Chloxeo/SCALAR-7_Sequenceur/images/BOTTOM.png

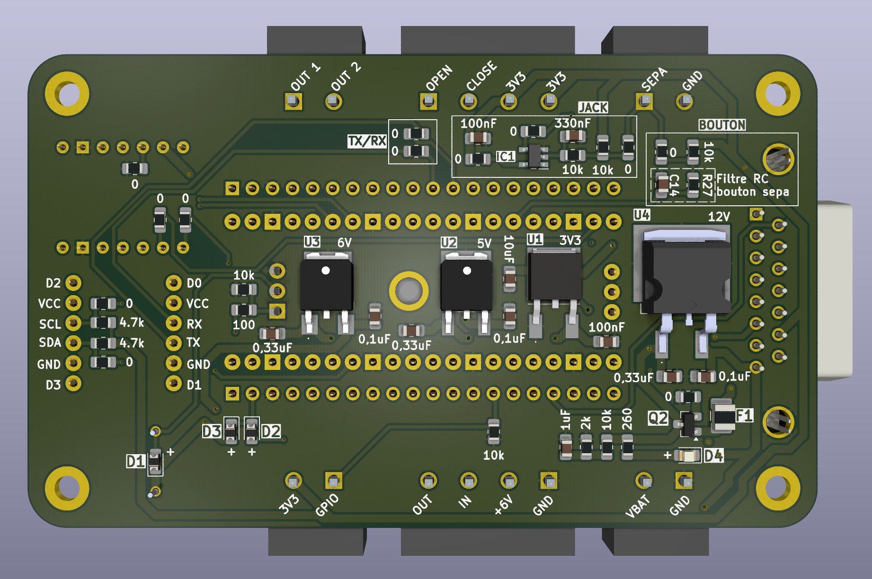
images/BOTTOM.png
