Chloxeo/SCALAR-7_Sequenceur/images/FRONT.png

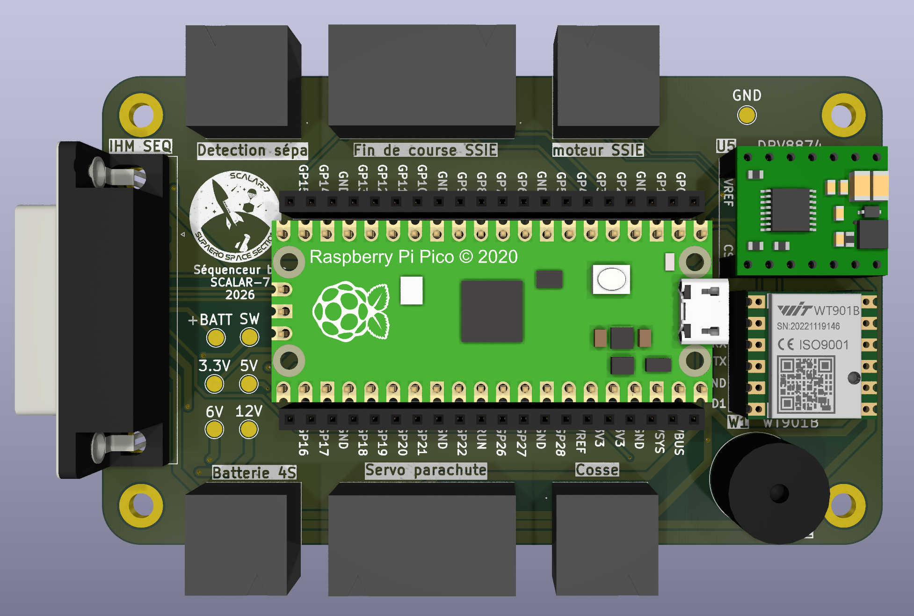
images/FRONT.png
