Chloxeo/SCALAR-7_Sequenceur/schematic.pdf

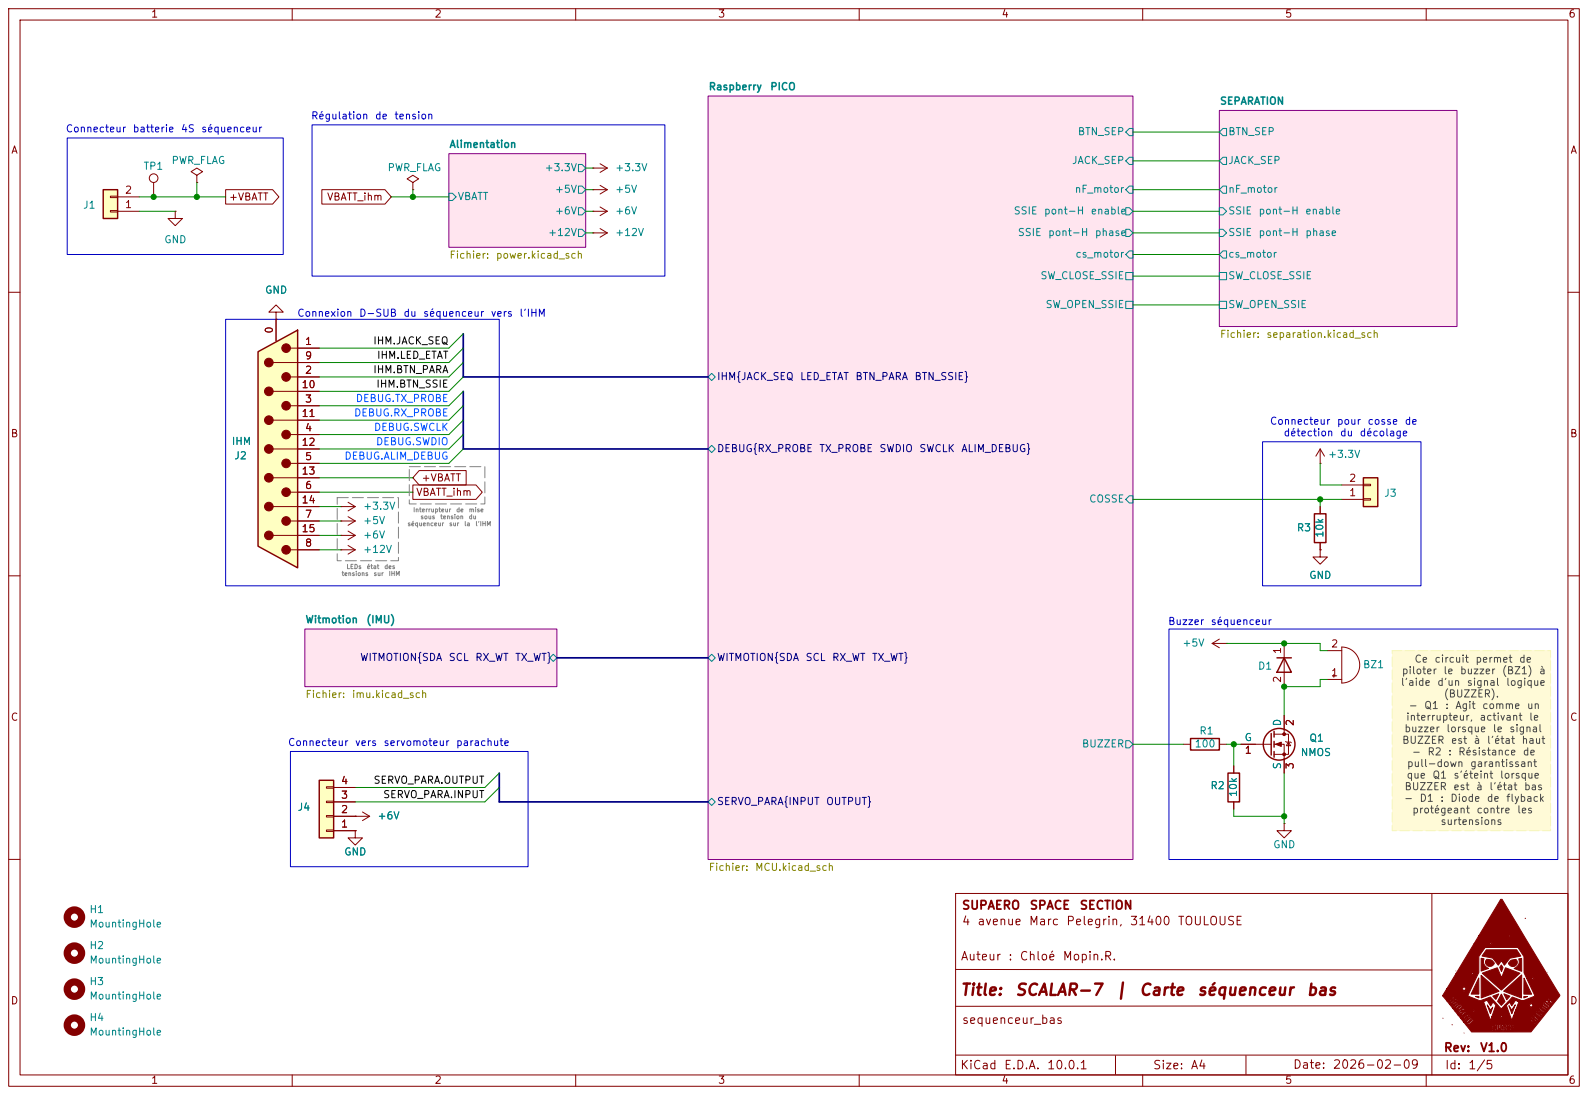
[picture p4: page 1]

Régulation de tension Connexion D-SUB du séquenceur vers l'IHM
IHM.LED_ETAT DEBUG.TX_PROBE SERVO_PARA.INPUT SERVO_PARA.OUTPUT DEBUG.RX_PROBE
IHM.BTN_PARA DEBUG.SWCLK
IHM.BTN_SSIE DEBUG.SWDIO

SSIE pont-H enable SSIE pont-H phase

SSIE pont-H enable SSIE pont-H phase SW_CLOSE_SSIE SW_OPEN_SSIE

Interrupteur de mise sous tension du séquenceur sur la l'IHM LEDs état des

tensions sur IHM Connecteur vers servomoteur parachute

Ce circuit permet de piloter le buzzer (BZ1) à

l'aide d'un signal logique
(BUZZER). - Q1 : Agit comme un

interrupteur, activant le buzzer lorsque le signal BUZZER est à l'état haut - R2 : Résistance de pull-down garantissant que Q1 s'éteint lorsque BUZZER est à l'état bas - D1 : Diode de flyback

SUPAERO SPACE SECTION
4 avenue Marc Pelegrin, 31400 TOULOUSE

Auteur : Chloé Mopin.R.
Title: SCALAR-7 | Carte séquenceur bas
sequenceur_bas

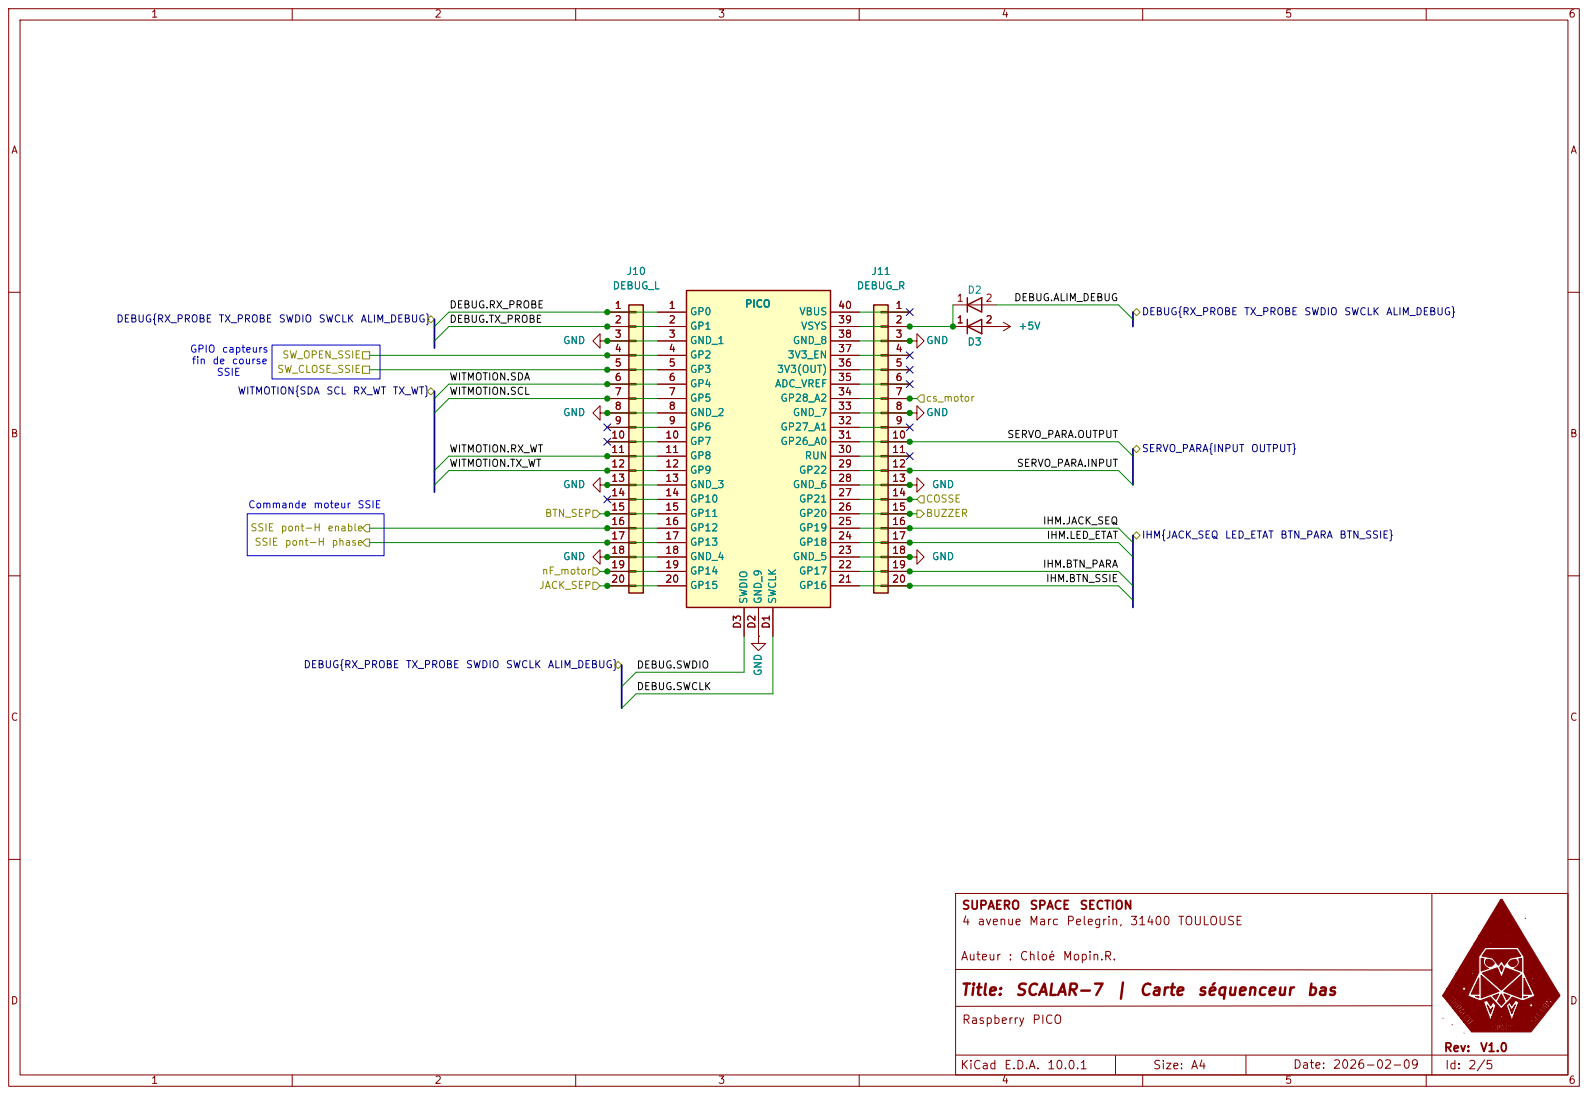
[picture p5: page 2]

IHM.BTN_PARA Commande moteur SSIE GPIO capteurs

SERVO_PARA{INPUT OUTPUT} COSSE BUZZER

18 18 GND 19 19

SUPAERO SPACE SECTION
4 avenue Marc Pelegrin, 31400 TOULOUSE

Auteur : Chloé Mopin.R.
Title: SCALAR-7 | Carte séquenceur bas
Raspberry PICO

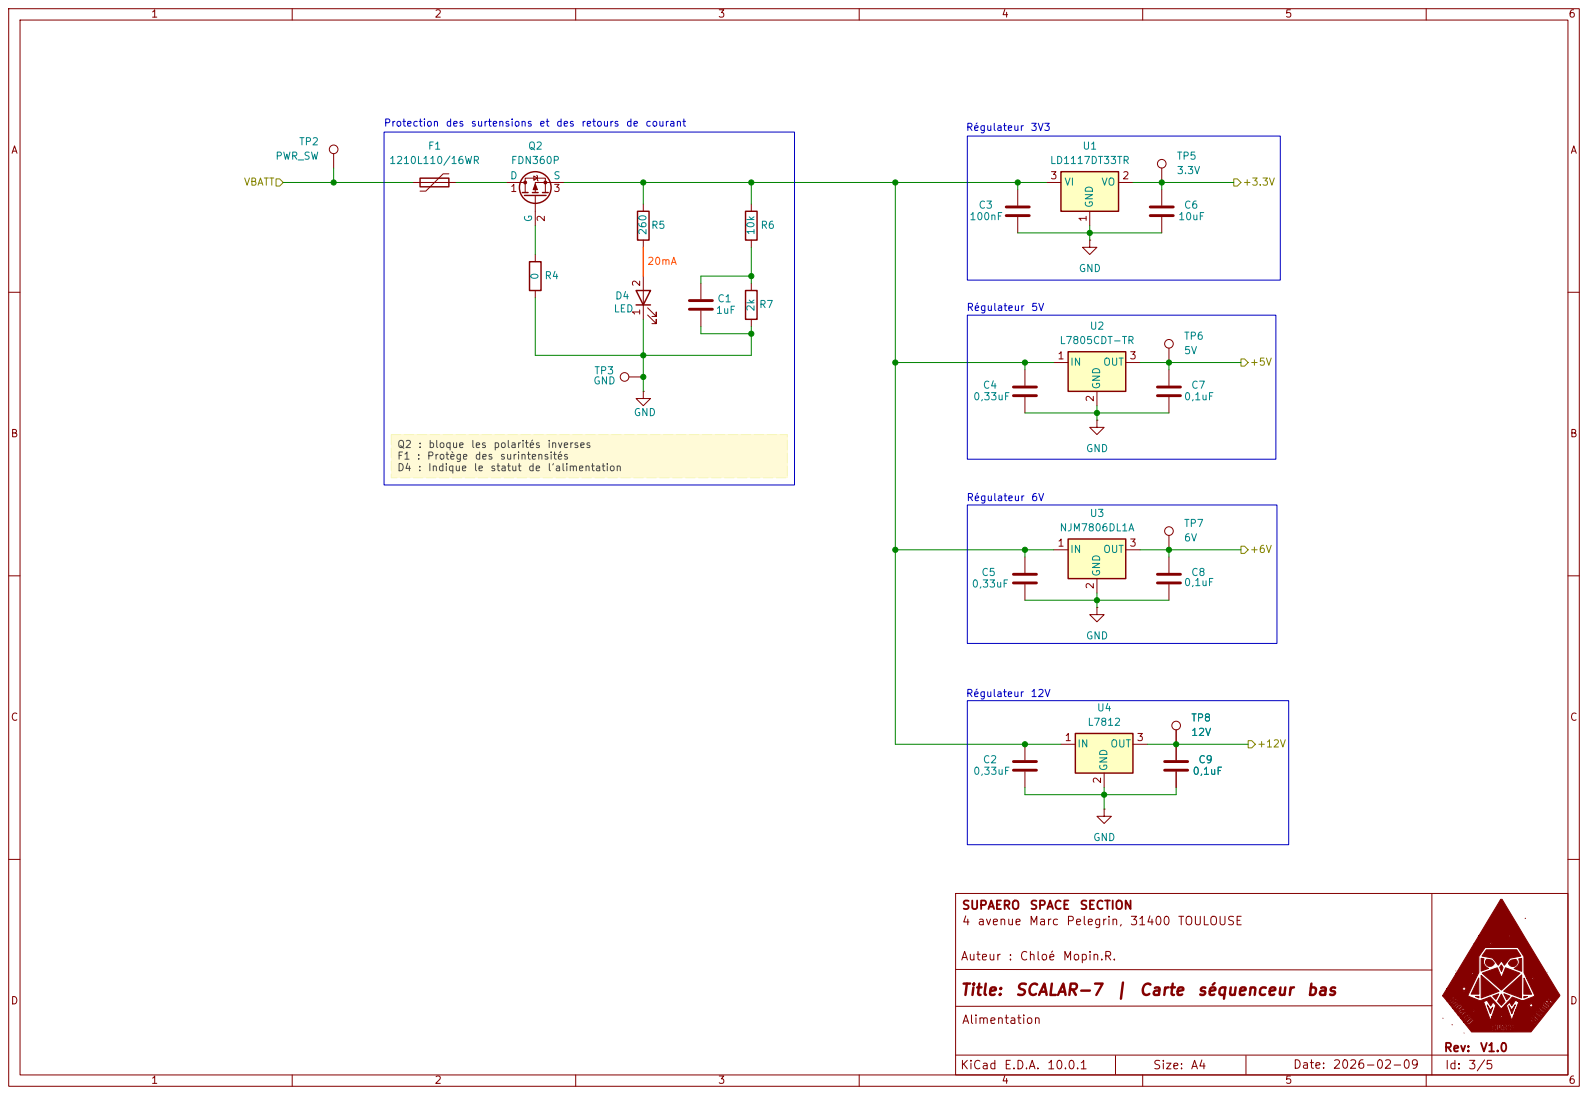
[picture p6: page 3]

SUPAERO SPACE SECTION
4 avenue Marc Pelegrin, 31400 TOULOUSE

Auteur : Chloé Mopin.R.
Title: SCALAR-7 | Carte séquenceur bas
Alimentation

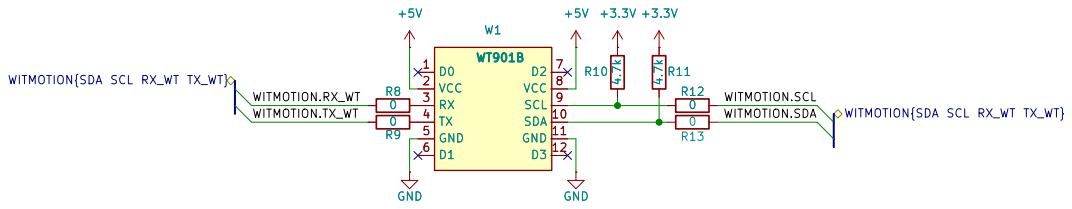
[picture p7: page 4]

SUPAERO SPACE SECTION
4 avenue Marc Pelegrin, 31400 TOULOUSE

Auteur : Chloé Mopin.R.
Title: SCALAR-7 | Carte séquenceur bas
Witmotion (IMU)

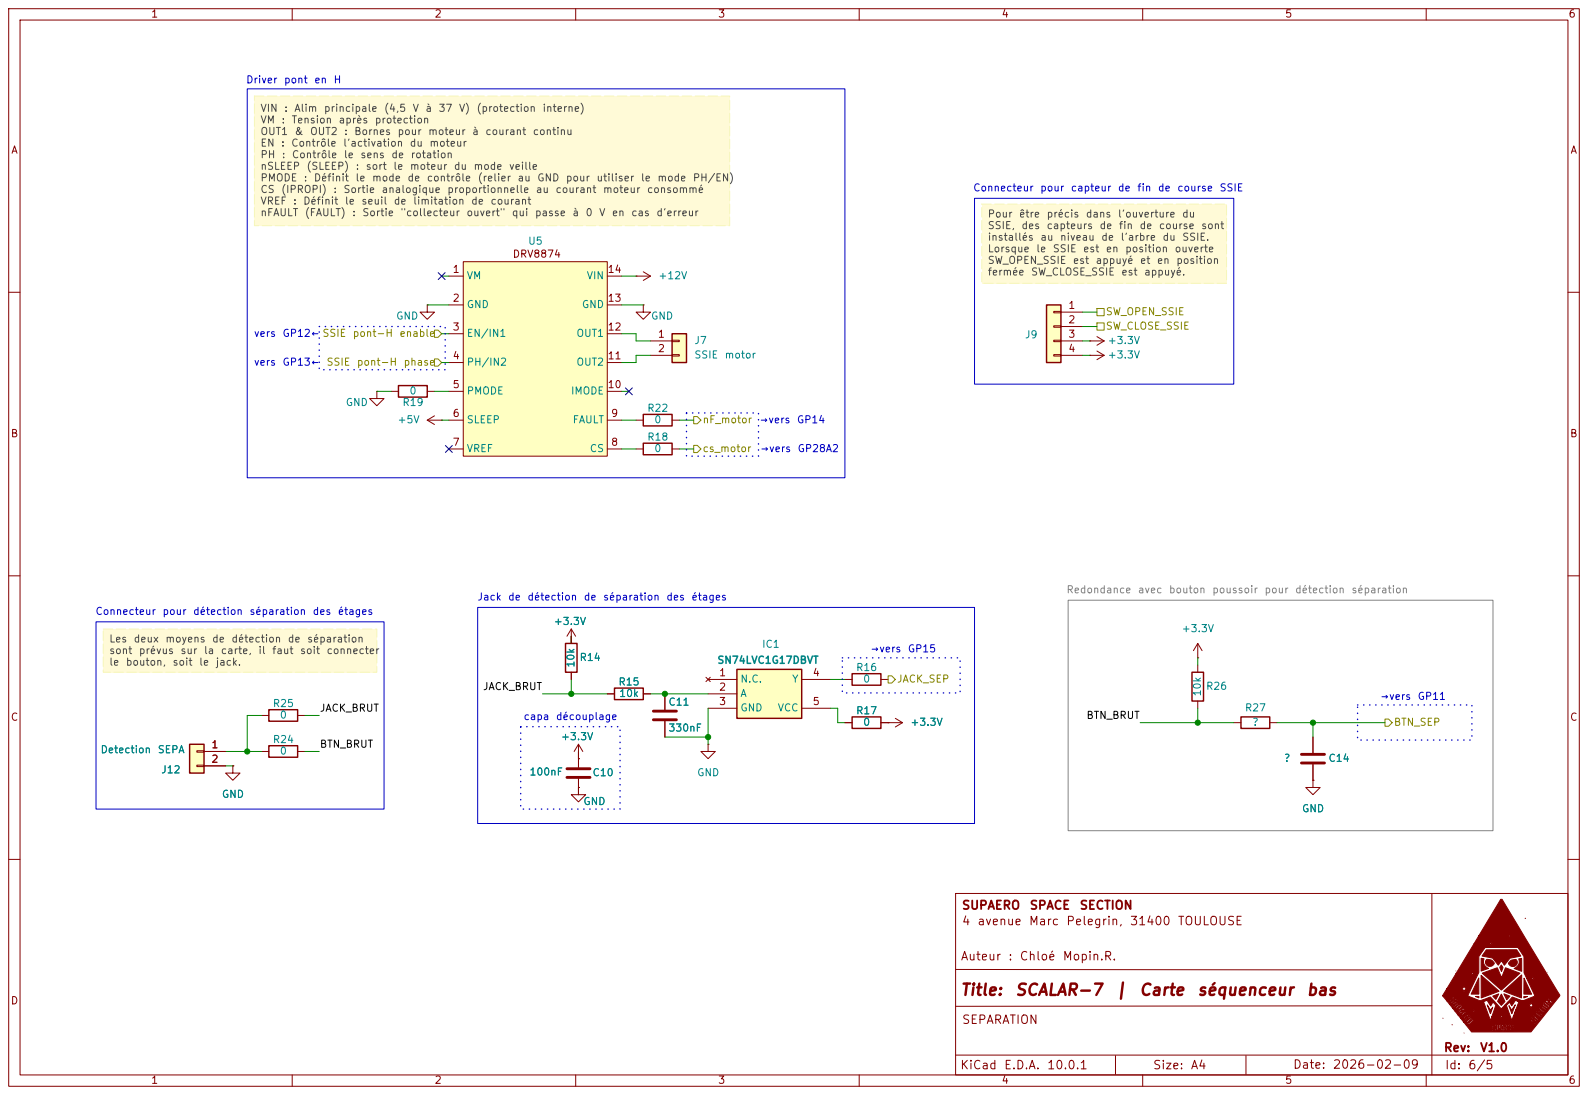
[picture p8: page 5]

VIN : Alim principale (4,5 V à 37 V) (protection interne) VM : Tension après protection OUT1 & OUT2 : Bornes pour moteur à courant continu

EN : Contrôle l'activation du moteur PH : Contrôle le sens de rotation

nSLEEP (SLEEP) : sort le moteur du mode veille PMODE : Définit le mode de contrôle (relier au GND pour utiliser le mode PH/EN) CS (IPROPI) : Sortie analogique proportionnelle au courant moteur consommé

Pour être précis dans l'ouverture du SSIE, des capteurs de fin de course sont

installés au niveau de l'arbre du SSIE. Lorsque le SSIE est en position ouverte SW_OPEN_SSIE est appuyé et en position

fermée SW_CLOSE_SSIE est appuyé. Les deux moyens de détection de séparation

nF_motor SSIE pont-H enable SSIE pont-H phase

Jack de détection de séparation des étages

sont prévus sur la carte, il faut soit connecter
le bouton, soit le jack.

SUPAERO SPACE SECTION
4 avenue Marc Pelegrin, 31400 TOULOUSE

Auteur : Chloé Mopin.R.
Title: SCALAR-7 | Carte séquenceur bas
SEPARATION
