Chloxeo/SCALAR-7_Sequenceur/hardware/sequenceur_bas.kicad_pcb

## KiCad design hardware/sequenceur_bas.kicad_pcb (2026-11-06)

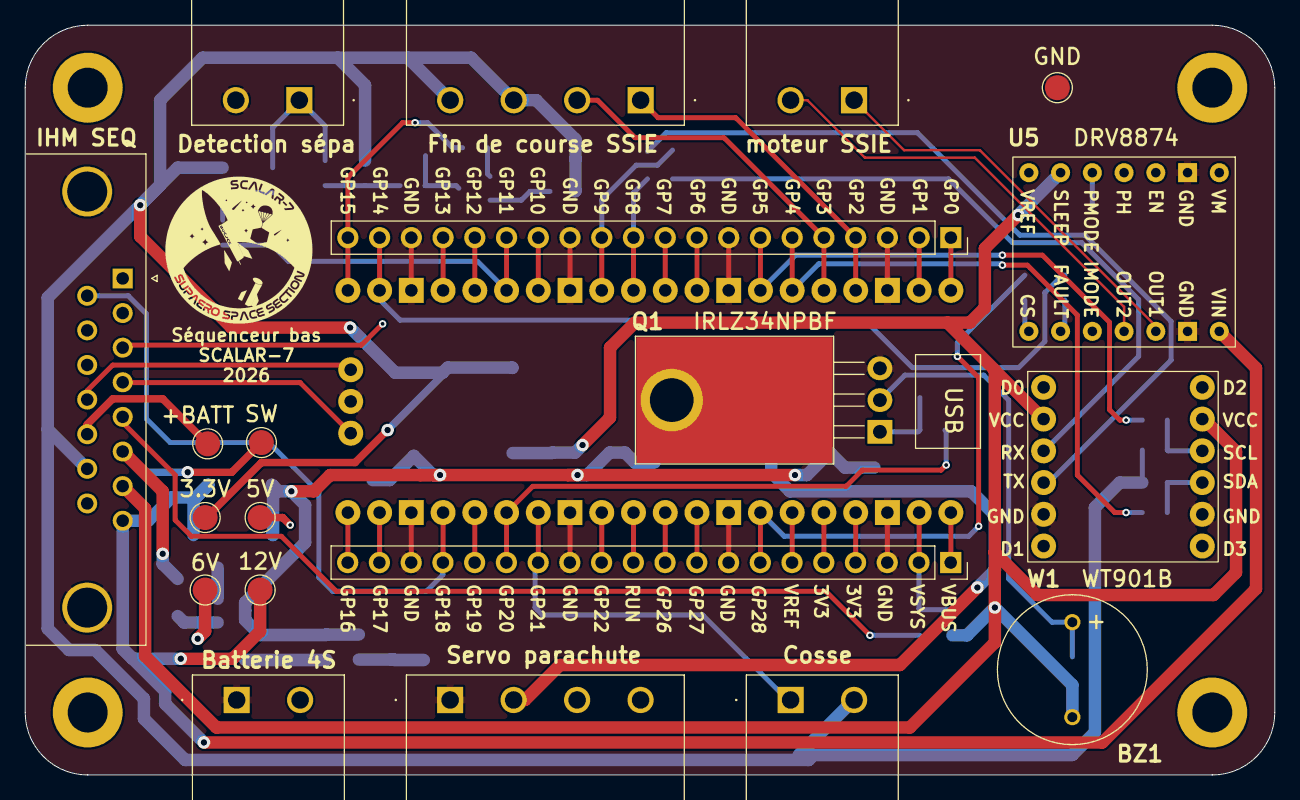
[picture p9: board sequenceur_bas.kicad_pcb from above]

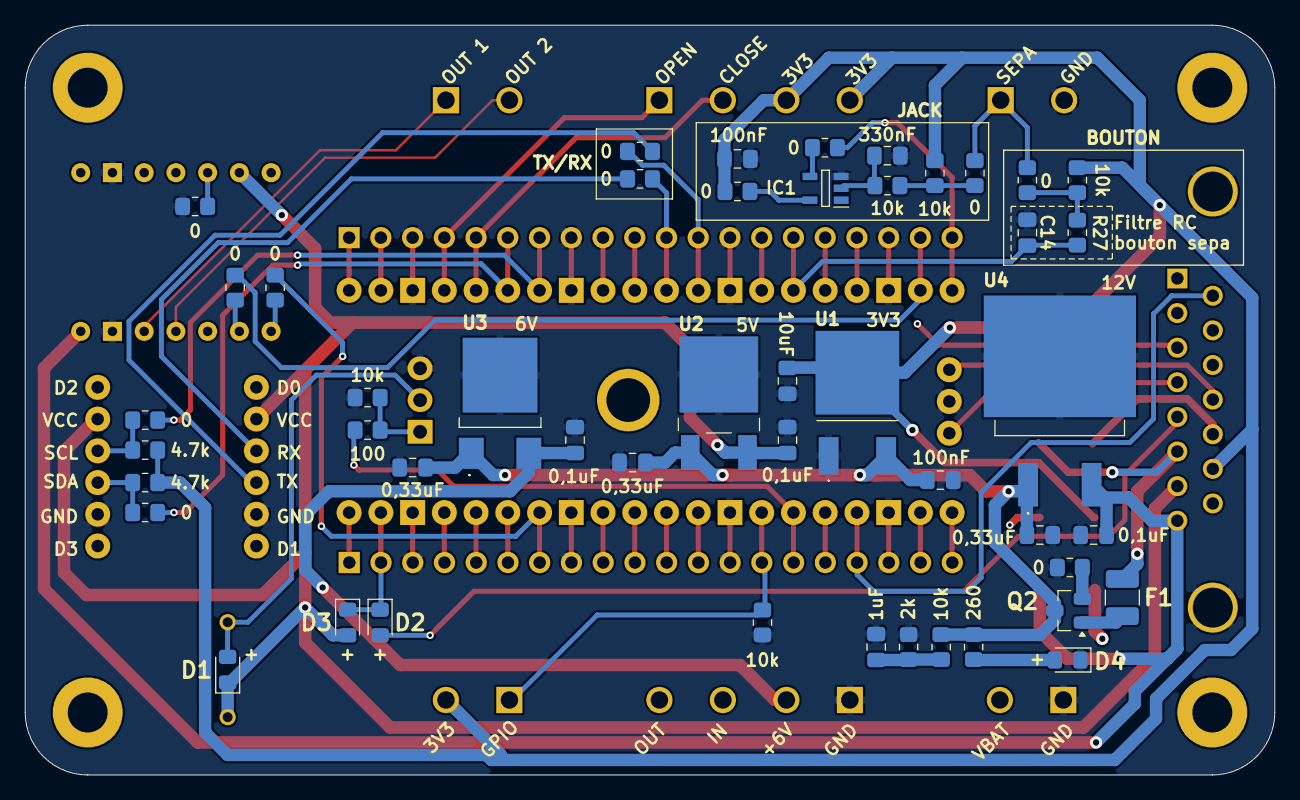
[picture p10: board sequenceur_bas.kicad_pcb from below]

Board: 4 copper layers, 100.0 x 60.0 mm, 72 parts (47 on the bottom side), 55 nets.

Parts:
BZ1: Buzzer; KXG1205C
C1: 1uF; C_0805_2012Metric_Pad1.18x1.45mm_HandSolder
C2, C4, C5: 0,33uF; C_0805_2012Metric_Pad1.18x1.45mm_HandSolder
C3, C10: 100nF; C_0805_2012Metric_Pad1.18x1.45mm_HandSolder
C6: 10uF; C_0805_2012Metric_Pad1.18x1.45mm_HandSolder
C7, C8, C9: 0,1uF; C_0805_2012Metric_Pad1.18x1.45mm_HandSolder
C11: 330nF; C_0805_2012Metric_Pad1.18x1.45mm_HandSolder
C14: ?; C_0805_2012Metric_Pad1.18x1.45mm_HandSolder
D1, D2, D3: D; D_0805_2012Metric_Pad1.15x1.40mm_HandSolder
D4: LED; LED_0805_2012Metric_Pad1.15x1.40mm_HandSolder
F1: 1210L110/16WR; Fuse_1210_3225Metric_Pad1.42x2.65mm_HandSolder
H1, H2, H3, H4: MountingHole; MountingHole_3.2mm_M3
IC1: SN74LVC1G17DBVT; SOT95P280X145-5N
J1: Batterie 4S; Bornier_Enfichable_2Pin_5mm_Horizontal
J2: IHM SEQ; DSUB-15_Pins_Horizontal_P2.77x2.84mm_EdgePinOffset4.94mm_Ho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
J3: Cosse; Bornier_Enfichable_2Pin_5mm_Horizontal
J4: Servo parachute; Bornier_Enfichable_4Pin_5mm_Horizontal
J5: PICO
J7: moteur SSIE; Bornier_Enfichable_2Pin_5mm_Horizontal
J9: Fin de course SSIE; Bornier_Enfichable_4Pin_5mm_Horizontal
J10: DEBUG_L; PinSocket_1x20_P2.54mm_Vertical
J11: DEBUG_R; PinSocket_1x20_P2.54mm_Vertical
J12: Detection sépa; Bornier_Enfichable_2Pin_5mm_Horizontal
Q1: IRLZ34NPBF; TO-220-3_Horizontal_TabDown
Q2: FDN360P; SuperSOT-3
R1: 100; R_0805_2012Metric_Pad1.20x1.40mm_HandSolder
R2, R3, R6, R14, R15, R26: 10k; R_0805_2012Metric_Pad1.20x1.40mm_HandSolder
R4, R8, R9, R12, R13, R16, R17, R18, R19, R22, R24, R25: 0; R_0805_2012Metric_Pad1.20x1.40mm_HandSolder
R5: 260; R_0805_2012Metric_Pad1.20x1.40mm_HandSolder
R7: 2k; R_0805_2012Metric_Pad1.20x1.40mm_HandSolder
R10, R11: 4.7k; R_0805_2012Metric_Pad1.20x1.40mm_HandSolder
R27: ?; R_0805_2012Metric_Pad1.20x1.40mm_HandSolder
TP1: +BATT; TestPoint_Pad_D2.0mm
TP2: SW; TestPoint_Pad_D2.0mm
TP3: GND; TestPoint_Pad_D2.0mm
TP5: 3.3V; TestPoint_Pad_D2.0mm
TP6: 5V; TestPoint_Pad_D2.0mm
TP7: 6V; TestPoint_Pad_D2.0mm
TP8: 12V; TestPoint_Pad_D2.0mm
U1: LD1117DT33TR
U2: L7805CDT-TR; L7805CDTTR
U3: NJM7806DL1A; NJM2845DL133TE1
U4: L7812; L7812CD2TTR
U5: DRV8874
W1: WT901B

Connections:
+3.3V: C6.1, C10.2, J2.14, J3.2, J9.3, J9.4, R10.2, R11.2, R14.2, R17.2, R26.2, TP5.1, U1.2 (VO)
+5V: BZ1.2 (-), C7.1, D1.1 (K), D3.2 (A), J2.7, TP6.1, U2.3 (OUT), U5.6 (SLEEP), W1.2 (VCC), W1.8 (VCC)
+6V: C8.1, J2.15, J4.2, TP7.1, U3.3 (OUT)
+12V: C9.1, J2.8, TP8.1, U4.3 (OUT), U5.14 (VIN)
+VBATT: J1.2, J2.13, TP1.1
/Raspberry PICO/BTN_SEP: C14.2, J5.15 (GP11), J10.15, R27.1
/Raspberry PICO/BUZZER: J5.26 (GP20), J11.15, R1.1
/Raspberry PICO/COSSE: J3.1, J5.27 (GP21), J11.14, R3.1
/Raspberry PICO/DEBUG.ALIM_DEBUG: D2.2 (A), J2.5
/Raspberry PICO/DEBUG.RX_PROBE: J2.11 (P111), J5.1 (GP0), J10.1
/Raspberry PICO/DEBUG.SWCLK: J2.4, J5.D1 (SWCLK)
/Raspberry PICO/DEBUG.SWDIO: J2.12, J5.D3 (SWDIO)
/Raspberry PICO/DEBUG.TX_PROBE: J2.3, J5.2 (GP1), J10.2
/Raspberry PICO/IHM.BTN_PARA: J2.2, J5.22 (GP17), J11.19
/Raspberry PICO/IHM.BTN_SSIE: J2.10, J5.21 (GP16), J11.20
/Raspberry PICO/IHM.JACK_SEQ: J2.1, J5.25 (GP19), J11.16
/Raspberry PICO/IHM.LED_ETAT: J2.9, J5.24 (GP18), J11.17
/Raspberry PICO/JACK_SEP: J5.20 (GP15), J10.20, R16.2
/Raspberry PICO/SERVO_PARA.INPUT: J4.3, J5.29 (GP22), J11.12
/Raspberry PICO/SERVO_PARA.OUTPUT: J4.4, J5.31 (GP26_A0), J11.10
/Raspberry PICO/SSIE pont-H enable: J5.16 (GP12), J10.16, U5.3 (EN/IN1)
/Raspberry PICO/SSIE pont-H phase: J5.17 (GP13), J10.17, U5.4 (PH/IN2)
/Raspberry PICO/SW_CLOSE_SSIE: J5.5 (GP3), J9.2, J10.5
/Raspberry PICO/SW_OPEN_SSIE: J5.4 (GP2), J9.1, J10.4
/Raspberry PICO/WITMOTION.RX_WT: J5.11 (GP8), J10.11, R8.1
/Raspberry PICO/WITMOTION.SCL: J5.7 (GP5), J10.7, R12.2
/Raspberry PICO/WITMOTION.SDA: J5.6 (GP4), J10.6, R13.1
/Raspberry PICO/WITMOTION.TX_WT: J5.12 (GP9), J10.12, R9.2
/Raspberry PICO/cs_motor: J5.34 (GP28_A2), J11.7, R18.2
/Raspberry PICO/nF_motor: J5.19 (GP14), J10.19, R22.2
/SEPARATION/BTN_BRUT: R24.2, R26.1, R27.2
/SEPARATION/JACK_BRUT: R14.1, R15.1, R25.2
GND: C1.2, C2.2, C3.2, C4.2, C5.2, C6.2, C7.2, C8.2, C9.2, C10.1, C11.1, C14.1, D4.1 (K), IC1.3 (GND), J1.1, J2.0, J4.1, J5.3 (GND_1), J5.8 (GND_2), J5.13 (GND_3), J5.18 (GND_4), J5.23 (GND_5), J5.28 (GND_6), J5.33 (GND_7), J5.38 (GND_8), J5.D2 (GND_9), J10.3, J10.8, J10.13, J10.18, J11.3, J11.8, J11.13, J11.18, J12.2, Q1.3 (S), R2.2, R3.2, R4.2, R7.2, R19.2, TP3.1, U1.1 (GND), U2.2 (GND), U3.2 (GND), U4.2 (GND), U5.2 (GND), U5.13 (GND), W1.5 (GND), W1.11 (GND)
unnamed: BZ1.1 (+), D1.2 (A), Q1.2 (D)
unnamed: C1.1, R6.2, R7.1
unnamed: D2.1 (K), D3.1 (K), J5.39 (VSYS), J11.2
unnamed: D4.2 (A), R5.2
unnamed: C11.2, IC1.2 (A), R15.2
unnamed: IC1.5 (VCC), R17.1
unnamed: IC1.4 (Y), R16.1
unnamed: J7.1, U5.12 (OUT1)
unnamed: J7.2, U5.11 (OUT2)
unnamed: J12.1, R24.1, R25.1
unnamed: Q1.1 (G), R1.2, R2.1
unnamed: F1.2, Q2.1 (D)
unnamed: Q2.2 (G), R4.1
unnamed: C2.1, C3.1, C4.1, C5.1, Q2.3 (S), R5.1, R6.1, U1.3 (VI), U2.1 (IN), U3.1 (IN), U4.1 (IN)
unnamed: R18.1, U5.8 (CS)
unnamed: R22.1, U5.9 (FAULT)
unnamed: R19.1, U5.5 (PMODE)
unnamed: R8.2, W1.3 (RX)
unnamed: R10.1, R12.1, W1.9 (SCL)
unnamed: R11.1, R13.2, W1.10 (SDA)
unnamed: R9.1, W1.4 (TX)
VBATT_ihm: F1.1, J2.6, TP2.1
